JamisHoo/Cache-CPU/slides/decaf.pdf

# 编译原理扩展实验

胡津铭 李天润 孙皓
2015.1.24

# 实验⺫⽬目标

- 改造Decaf/Mind编译器，使⽣生成代码能运⾏行在
- 基于MIPS32指令⼦子集的多周期处理器
- μcore OS

# 实现⽅方法

- 指令集
- add, sub, neg
- mul
- div, rem

# 实现⽅方法

- 库函数
- PrintString
- PrintInt
- PrintBool
- ReadLine
- ReadInteger
- Halt
- Allocate
- Div
- Mod

# 实现⽅方法

- 函数调⽤用
- μcore采⽤用o32 ABI
- Decaf全部在栈上传递
- 添加中间层函数

# 实现⽅方法

- 程序退出
- μcore OS要求程序返回0
- Decaf返回类型为void
- main函数返回前加⼊入move $v0, $zero

# 实现⽅方法

- string类型
- Decaf没有垃圾回收机制
- μcore⽤用户态申请堆空间功能不完善
- 使⽤用静态存储区模拟动态分配

# 实验结果

- 含有乘法、除法运算的math
- 递归函数调⽤用的fibonacci
- 标准输⼊入输出、模运算的blackjack

# Thanks！
