JamisHoo/Cache-CPU/product_requirement_document/sections/section1_introduction.tex

\section{引言}
    \subsection{编写目的}
        计算机组成原理32位MIPS实验是在计原16位实验的基础上的扩展。%
        在实验原理方面与多门课程相结合，%
        涉及到操作系统、软件工程、编译原理等等多个方面，%
        实验初期学习曲线较陡，在原理方面比较难以掌控。%
        在编程实现方面涉及到大规模VHDL代码的书写，%
        需要对数字逻辑设计有比较清晰的思路，工作量非常大。

        因此，为控制整个开发过程，明确项目需求与目标，编写此需求文档。 

        文档预期读者为任务提出者：刘卫东老师、李山山老师、白晓颖老师。
    \subsection{背景}
        系统名称：32位MIPS处理器

        任务提出者：
        \begin{minipage}[t]{0.8\linewidth}
        计算机组成原理课程：刘卫东老师、李山山老师

        软件工程课程：白晓颖老师
        \end{minipage}

        开发者：
        \begin{minipage}[t]{0.8\linewidth}
        计23 李天润

        计23 胡津铭

        计23 孙皓
        \end{minipage}

    \subsection{定义}
        以下是此次32位MIPS实验中需要用到的专业名词定义

        \begin{table}[!hbp]
        \centering
        \caption{定义列表}
        \begin{tabular}{|c|c|}
        \hline
        名词 & 描述 \\
        \hline
        MIPS & 无内部互锁流水级的微处理器 \\
        \hline
        CPU &  中央处理器\\
        \hline
        CP0 & 协处理器0 \\
        \hline
        MMU & 内存管理单元 \\
        \hline
        TLB & 翻译后备缓冲 \\
        \hline
        ALU & 算术逻辑单元 \\
        \hline
        RAM & 存储程序的硬件，断电不保存信息 \\
        \hline
        ROM & 存储程序的硬件，断电可保存信息 \\
        \hline
        Flash & 存储程序的硬件，断电可保存信息，实验中用作硬盘 \\
        \hline
        BIOS & 主板上的启动程序，负责初始化硬件引导操作系统 \\
        \hline
        BootLoader & 一段特殊程序，将操作系统从Flash中加载到内存中，并且开始执行 \\
        \hline
        \end{tabular}
        \end{table}

    \subsection{参考资料}
        实验指导文档

        OsLab实验参考文档

        计算机组成原理综合实验报告 贾开

        《计算机组成和设计 硬件/软件接口》

        《See MIPS Run》
