JamisHoo/Cache-CPU/technical_documentation/sections/section6_dirtree.tex

\section{文件结构}
    \dirtree{%
        .1 /.
            .2 bin\DTcomment{二进制文件}.
                .3 cacpu.bit\DTcomment{CPU，烧入FPGA}.
                .3 cpld.jed\DTcomment{烧入CPLD}.
                .3 kernel\DTcomment{操作系统内核}.
                .3 sfs.img\DTcomment{文件系统}.
                .3 cadb.bit\DTcomment{带有Cache Debugger调试工具的CPU}.
            .2 design\DTcomment{设计资料}.
                .3 datapath.xls\DTcomment{数据通路指令信号说明}.
            .2 product\_requirement\_document\DTcomment{需求文档}.
            .2 src\DTcomment{源代码}.
                .3 cacpu\DTcomment{Cache CPU}.
                    .4 cacpu.xise\DTcomment{工程文件}.
                    .4 CP0.vhd\DTcomment{CP0模块}.
                    .4 Exception.vhd\DTcomment{异常处理模块}.
                    .4 IDecode.vhd\DTcomment{指令解析模块}.
                    .4 IDecode\_const.vhd\DTcomment{指令解析常量}.
                    .4 IFetch.vhd\DTcomment{取指令模块}.
                    .4 WB.vhd\DTcomment{写回模块}.
                    .4 alu.vhd\DTcomment{ALU模块}.
                    .4 async.v\DTcomment{开源串口异步收发模块}.
                    .4 cacpu.ucf\DTcomment{管脚绑定}.
                    .4 cacpu.vhd\DTcomment{顶层控制模块}.
                    .4 common.vhd\DTcomment{通用常量}.
                    .4 flash.vhd\DTcomment{Flash操作模块}.
                    .4 general\_register.vhd\DTcomment{通用寄存器模块}.
                    .4 mem.vhd\DTcomment{访存模块}.
                    .4 mmu\_module.vhd\DTcomment{MMU模块}.
                    .4 phy\_mem.vhd\DTcomment{物理访存模块}.
                    .4 ram.vhd\DTcomment{RAM读写模块}.
                    .4 rom.vhd\DTcomment{ROM读写模块}.
                .3 cpld\DTcomment{CPLD}.
                    .4 cpld.ucf\DTcomment{管脚绑定}.
                    .4 cpld.vhd\DTcomment{转发程序}.
                    .4 cpld.xise\DTcomment{工程文件}.
                .3 cadb\DTcomment{Cache Debugger}.
                    .4 com\_debug.vhd\DTcomment{调试命令收发解析}.
                    .4 bp\_debug.vhd\DTcomment{调试控制模块}.
                    .4 testcpu.vhd\DTcomment{顶层模块}.
                    .4 testcpu.ucf\DTcomment{管脚绑定}.
            .2 technical\_documentation\DTcomment{技术文档}.
            .2 ucore\_modified\DTcomment{修改后的ucore}.
                .3 lab8\DTcomment{lab8源代码}.
            .2 utils\DTcomment{调试工具}.
                .3 cadb\DTcomment{GDB调试工具}.
                .3 com2flash\DTcomment{flash与ram的读写工具}.
                .3 rom\DTcomment{rom生成工具}.
                .3 terminal\DTcomment{电脑接收端}.
    }
