JamisHoo/Cache-CPU/utils/cadb/manual/sections/section_overview.tex

\section{概述}
    \subsection{用途}
        Cache Debugger是一个基于串口的VHDL通用调试工具。%
        使用本工具可以在PC端发送指令到硬件系统，%
        具有启动、断点、继续运行、单步调试、查看信号等多种功能。%

    \subsection{系统配置}
        带有串口的目标设备
        
        支持VHDL语言和该目标设备的集成软件开发环境

        Unix或类Unix操作系统，安装有串口设备驱动，支持C++11的编译器
