JamisHoo/Cache-CPU/documentation/cadb_technical_document.pdf

# Cache Debugger技术文档

### Cache小组

2015年1月11日

目录

1 引言 | 2
2 设计原理 | 2
3 硬件部分 | 2
4 软件部分 | 5
5 高级应用 | 7

1

1 引言

### 1.1 开发信息

系统名称：硬件调试工具Cache Debugger
开发者： 计23 李天润
计23 胡津铭
计23 孙皓

### 1.2 内容简介

本文档介绍了硬件调试工具的功能设计以及软硬件部分实现细节，方便读者 更深入了解本工具的运行方式，以及根据自己的需要对工具进行修改、二次开 发。
本文档假设读者已经阅读过调试工具的使用手册，并且了解硬件描述语言的 基本应用以及元件例化的方法。

## 2 设计原理

硬件逻辑分时序逻辑与组合逻辑，其中组合逻辑仅与输入有关，时序逻辑受 时钟控制。
在系内课程与FPGA有关的实验中，并没有涉及与延时相关的逻辑，比如振 荡电路，因此FPGA芯片内部的硬件延时在设计硬件逻辑时一般不会被考虑，仅 影响时钟频率的提高。基于以上考虑，可以认为大多数实验中，硬件逻辑的执 行是由时钟驱动的，因此控制了时钟也就控制了逻辑的执行。而且，由于设计 逻辑时不会将延时作为正面的逻辑功能的一部分，时钟沿无论延迟多久到达都 不会产生负面作用，因此暂停时钟相当于将电路暂停，之后再次给入时钟信号 即可无损地继续执行程序。
本工具正是基于以上结论，结合调试的断点信息，产生被调试模块的时钟信 号，使得被调试模块既可正常运行，又可以在给定的状态下暂停，查看调试信 息。
通过逻辑操作，本工具可以为被调试模块提供与调试工具的输入时钟信号相 同频率的时钟信号，使得被调试模块在调试环境下有着与实际单独运行时几乎 相同的表现。

## 3 硬件部分

### 3.1 整体设计

硬件部分，需要在软件客户端的控制下，产生适当的时钟信号，控制程序运 行指定的时钟数或者运行到指定的断点状态。
运行结束之后，应当将硬件上的信号值发送到客户端，以供调试人员查看信 号值，分析芯片运行状况。
调试工具的硬件部分工作流程如图1。

2

图 1: 硬件部分工作流程示意图

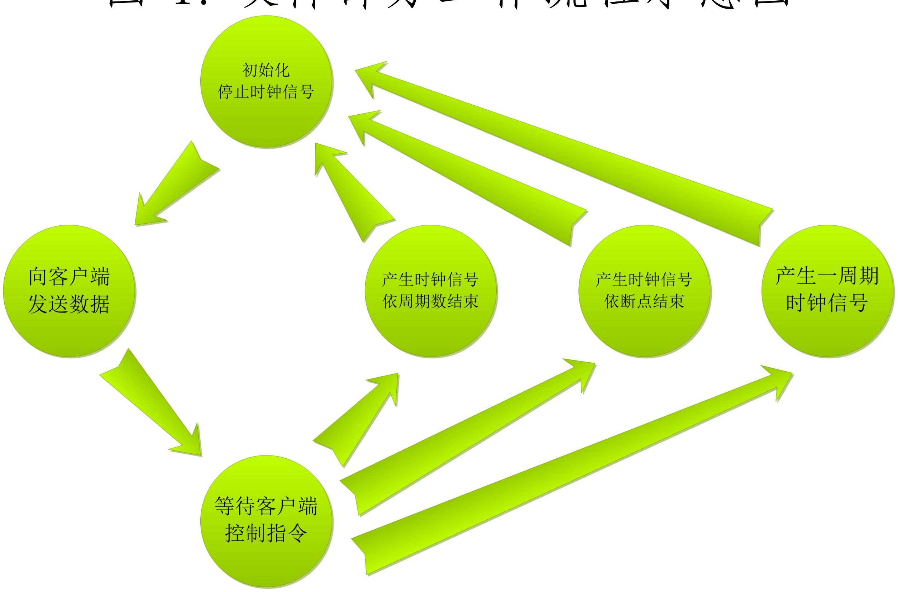
[picture p15: figure]

上述功能由两个模块实现，一个模块用于与客户端进行通信，另一个模块用 于控制被调试模块的时钟信号以及调试工具的状态跳转。

### 3.2 模块设计

3.2.1 控制模块

此模块位于bp_debug.vhd

3.2.1.1 端口说明

端口名 | 端口方向 端口类型
端口描述
clk | in | std_logic
| 时钟输入。
clk_o | out | std_logic
由此模块产生的时钟信号，可直接作为被测试模块的时
| 钟。
e | in | std_logic
| 使能信号。
datas | in | std_logic_vector ( 4095 downto 0 )
从被测试模块发来的信号值数据。
monitor | in | std_logic_vector ( 63 downto 0 )
从被测试模块发来的监控信号数据，用于断点的监控。
serialport_txd | out | std_logic
串口写端口。
serialport_rxd in | std_logic
| | 3

串口读端口。

3.2.1.2 内部实现
控制模块的状态机大致与调试工具硬件部分的工作流程相对应。 需要查看的信号值部分，从被调试模块获取信号值（默认长度为4096bit）， 使用组合逻辑的方法根据通信模块给出的字节编号选取对应的字节提供给通信 模块。
调试部分，目前仅支持在上升沿之前断点，实现方式为输出时钟由两个中 间值取异或得到。一个中间值的改变由输入时钟下降沿触发，在输出时钟为高 电平时对其取反。令一个中间值的改变由输入时钟上升沿触发，在程序运行阶 段，且仍需继续运行时，如果输出时钟为低电平，则将其取反。 被调试模块是否应当继续运行，根据指令的不同而有不同的判断方式。 对于断点调试而言，当检测信号与段电信号值相同时应当进行停止运行，否 则应当继续运行。
对于继续调试而言，应当无条件给出一个周期的时钟信号，然后按照断点调 试判断。
对于单步调试而言，设置一个倒计时计数器，每次时钟上升沿减一且被调试 模块运行，减到0时被调试模块停止运行。

3.2.2 通信模块

此模块位于com_debug.vhd

3.2.2.1 端口说明

端口名 | 端口方向 端口类型
端口描述
clk | in | std_logic
串口发送部分开始信号。
slc | out | std_logic_vector(15 downto 0)
串口发送的字节编号，用于从上层模块获取对应字节。
data | in | std_logic_vector ( 7 downto 0 )
串口发送的字节值，使用编号slc从上层模块获取。
serialport_txd | out | std_logic
串口写端口。
serialport_rxd in | std_logic
串口读端口。
data_coming | out | std_logic

4

标志位，表示客户端指令到来。
coming_data | out | std_logic_vector ( 135 downto 0 )
来自客户端的指令信息。 高64位为客户端第二个参数； 中 64位为客户端第一个参数； 低8位表示指令类型。
data_read | in | std_logic
标志位，表示这一指令已经被读取，可以消除指令到来信
号。

3.2.2.2 内部实现
通信模块包括接受与发送两部分，分别工作，相互不影响，通过软件端、控 制模块保证发送与接受的顺序。
发送部分用于运行结束时，向客户端发送需要的内部信号值。收到控制端的 发送开始信号后，从0号字节开始循环发送。这一部分使用slc端口给出字节编 号，然后由data读入字节信息，通过串口发送。
接收部分从软件端接受指令，收到17个字节后，通过标志位通知控制模块 数据到来，同时提供数据。收到控制模块读走数据的信号后，接收部分将数据 到来标志位清零，同时继续等待新数据到来。
此部分工作频率默认在50MHz，频率不符会导致此部分不能正常工作。修 改频率请在async.v中做修改。

## 4 软件部分

### 4.1 设计原理

软件端设计与硬件端匹配，与硬件端约定接收、发送规则，接收、发送消息 的格式，同时为了解决数据传输过程中可能出现的错误，还需要处理系统缓冲 区、检测丢包现象，从而保证调试工具正常运行。

### 4.2 整体设计

软件端开始运行后读取配置文件，尝试连接串口，以上操作均成功后，进入 用户操作界面。

4.2.1 通信命令编码

对于每个用户输入的命令，软件端将命令编码后发送给硬件端，根据命令类 型决定是否阻塞并等待硬件端数据。
通信编码共17字节，命令编码规则如下表所示。图中编码低序字节最先发 送，高序字节最后发送。
命令 | 通信编码 | 说明

5

run | 0x<128位全0>01 | 运行此命令后软件端阻塞，等 待硬件端数据。
break | 0x<64位掩码><64位数据>02 64位数据为断点条件，掩码为
| | 1表示数据有效，掩码为0表示 数据通配，数据和掩码均采用 小端法。
continue | 0x<128位全0>03 | 运行此命令后软件端阻塞，等 待硬件端数据。
step | 0x<64位全0><64位数据>04 | 64位数据为前进时钟数，运行 此命令后软件端阻塞，等待硬 件端数据。
print | | 此命令无需与硬件端通信。
display | | 此命令无需与硬件端通信。
undisplay | | 此命令无需与硬件端通信。
help | | 此命令无需与硬件端通信。
quit | | 此命令无需与硬件端通信。

4.2.2 通信数据编码

软件运行后会自动读取当前目录下cadb.cfg文件。配置文件需要用户自行编 写，共三列，第一列是软件端查看变量值时的标签，接受不包含空白字符的字 符串。 第二列是VHDL源代码中实际被查看信号名称，接收不包含空白字符的 字符串，在被调试模块中应有同名信号，且该信号不能为输出端口。 第三列是 被查看信号的范围。对于std_logic_vector应标明范围，对于std_logic第三列置 空。
生成VHDL代码时，程序会根据信号长度在通信数据格式中从低到高分配， 对于长度不是8的整数倍的信号，会填充0以实现8对齐。每次收到硬件端发送 的数据后，软件端会根据该格式解析出对应的信号值。因此每次修改配置文件 后都应该重新生成VHDL代码并应用到硬件中。数据在传输和保存过程中采用 小端法，因此在打印变量时从高序字节开始打印。
若要修改通信数据总长度，应在软件端源代码中修改类Parser的静态成员常 量MSG_LENGTH的值，同时在硬件端做相应修改。注意该值在软件端以字节为 单位，在硬件端以位为单位。

4.2.3 系统缓冲区管理

Unix操作系统中为串口设置有缓冲区，缓冲区大小因操作系统不同而有所 差异。
为了避免软件运行过程中受缓冲区原有数据影响而造成通信不同步，软件 启动时和run命令发送之前应清空系统缓冲区。清空方法为：不断尝试读取串 口，直到连续10ms读取不到数据为止。

6

4.2.4 丢包检测

在软硬件两端通信协议设置正确且硬件运行过程中能够到达断点条件的前提 下，软件端一直阻塞，则说明发生了串口传输丢包现象。此时应重启软件端。 本工具自开发使用以来从未发现丢包现象。

4.2.5 串口通信参数

软件端串口通信管理在源代码类Communicator中，如果需要修改波特率等 串口通信参数，请在硬件端和软件端同时修改。

## 5 高级应用

此部分涉及较多细节，请在理解本文档前述部分之后再进行阅读。

### 5.1 断点调试

本调试工具的断点调试可以按照64位均匹配的方式执行，也可以根据需要 进行一定的通配匹配。
对于包含通配符的断点信息，来自客户端的指令的第二个参数不再是 0xFFFFFFFF，而在需要通配的位上为0。断点的匹配是将断点值与监控值作 异或，如果结果为0x00000000，则表示到达断点。考虑通配符后，异或的结 果会再与通配值进行与操作，将被设为通配的位置0，从而使其不再参与断点 匹配。

### 5.2 观察信号变长

默认文件中，观察信号长度为4096bit，使用中可以将CPU顶层模块的所有 信号以及通用寄存器、CP0寄存器的所有信号发到客户端， 而且发送这一长度 的观察信号消耗的时间在通过终端查看的情况下可以忽略。 使用中，考虑到不同的使用者可能有不同的需要，比如自动调试中希望每次 发送更少的信号值或者需要发送更多的信号，在此给出改变观察信号长度的方 法。
改变观察信号长度，需要将被调试模块中的输出数据长度改变，调试模块的 输入数据长度改变。
接下来，需要将数据发送部分的字节编号范围改为需要的数值，此处需修改 com_debug.vhd中的常量slc_max。
最后，需要在软件端进行相应修改，使其一次性接受的信号数量匹配。

7
