JamisHoo/Cache-CPU/design/datapath.xls

Sheet: ALU控制
ALUOP |  |  | ALUOp改为5位
00000 | +
00001 | - | SrcA - SrcB
00010 | 是否相等
00011 | &
00100
00101 | ^
00110 | ~
00111 | << | SrcB << SrcA
01000 | >>（arith） | SrcB >> SrcA
01001 | >>（logic） | SrcB >> SrcA
01010 | 有符号小于比较 | 1<2?小于结果输出1，否则结果输出0
01011 | 无符号小于比较（一个需要元件例化） | 1<2?小于结果输出1，否则结果输出0
10000 | 乘法 | srcA*srcB
10001 | read_lo
10010 | read_hi
10011 | write_lo
10100 | write_hi
ALU输出
ans | 计算结果

Sheet: 多周期
指令 | 指令31-26 | 指令5-0
ADDIU | 001001 | XXXXXX | 执行 | ALUSrcA | ALUSrcB | ALUOp | Immediate |  | 写回 | RegDst | RegValue | PcSource
 |  |  |  | 00 | 01 | 0000 | 00 |  |  | 00 | 000 | 00
ADDU | 000000 | 100001 | 执行 | ALUSrcA | ALUSrcB | ALUOp |  |  | 写回 | RegDst | RegValue | PcSource
 |  |  |  | 00 | 00 | 0000 |  |  |  | 01 | 000 | 00
SLT | 000000 | 101010 | 执行 | AlUSrcA | ALUSrcB | ALUOp |  |  | 写回 | RegDst | RegValue | PcSource
 |  |  |  | 00 | 00 | 1010 |  |  |  | 01 | 000 | 00
SLTI | 001010 | XXXXXX | 执行 | ALUSrcA | ALUSrcB | ALUOp | Immediate |  | 写回 | RegDst | RegValue | PcSource
 |  |  |  | 00 | 01 | 1010 | 00 |  |  | 00 | 000 | 00
SLTIU | 001011 | XXXXXX | 执行 | ALUSrcA | ALUSrcB | ALUOp | Immediate |  | 写回 | RegDst | RegValue | PcSource
 |  |  |  | 00 | 01 | 1011 | 01 |  |  | 00 | 000 | 00
SLTU | 000000 | 101011 | 执行 | ALUSrcA | ALUSrcB | ALUOp |  |  | 写回 | RegDst | RegValue | PcSource
 |  |  |  | 00 | 00 | 1011 |  |  |  | 01 | 000 | 00
SUBU | 000000 | 100011 | 执行 | ALUSrcA | ALUSrcB | ALUOp |  |  | 写回 | RegDst | RegValue | PcSource
 |  |  |  | 00 | 00 | 0001 |  |  |  | 01 | 000 | 00
MULT | 000000 | 011000 | 执行 | ALUSrcA | ALUSrcB | ALUOp |  |  | 写回 | RegWrite |  | PcSource
 |  |  |  | 00 | 00 | 10000 |  |  |  | 0 |  | 00
MFLO | 000000 | 010010 | 执行 | ALUSrcA | ALUSrcB | ALUOp |  |  | 写回 | RegDst | RegValue | PcSource
 |  |  |  | 00 | 00 | 10001 |  |  |  | 01 | 000 | 00
MFHI | 000000 | 010000 | 执行 | ALUSrcA | ALUSrcB | ALUOp |  |  | 写回 | RegDst | RegValue | PcSource
 |  |  |  | 00 | 00 | 10010 |  |  |  | 01 | 000 | 00
MTLO | 000000 | 010011 | 执行 | ALUSrcA | ALUSrcB | ALUOp |  |  | 写回 | RegWrite |  | PcSource
 |  |  |  | 00 | 00 | 10011 |  |  |  | 0 |  | 00
MTHI | 000000 | 010001 | 执行 | ALUSrcA | ALUSrcB | ALUOp |  |  | 写回 | RegWrite |  | PcSource
 |  |  |  | 00 | 00 | 10100 |  |  |  | 0 |  | 00
BEQ | 000100 | XXXXXX | 执行 | Immediate | AluSrcA | AluSrcB | ALUOp |  | 写回 | PcSource | RegWrite
 |  |  |  | 00 | 00 | 00 | 0010 |  |  | 01 | 0
BGEZ | 000001 | XXXXXX |  | Immdiate | AluSrcA | AluSrcB | ALUOp |  | 写回 | PcSource | RegWrite
 |  |  |  | 00 | 00 | 10 | 0001 |  |  | 01 | 0
BGTZ | 000111 | XXXXXX |  | Immdiate | AluSrcA | AluSrcB | ALUOp |  | 写回 | PcSource | RegWrite
 |  |  |  | 00 | 00 | 10 | 0001 |  |  | 01 | 0
BLEZ | 000110 | XXXXXX |  | Immdiate | AluSrcA | AluSrcB | ALUOp |  | 写回 | PcSource | RegWrite
 |  |  |  | 00 | 00 | 10 | 0001 |  |  | 01 | 0
BLTZ | 000001 | XXXXXX |  | Immdiate | AluSrcA | AluSrcB | ALUOp |  | 写回 | PcSource | RegWrite
 |  |  |  | 00 | 00 | 10 | 0001 |  |  | 01 | 0
BNE | 000101 | XXXXXX |  | Immediate | AluSrcA | AluSrcB | ALUOp |  | 写回 | PcSource | RegWrite
 |  |  |  | 00 | 00 | 00 | 0010 |  |  | 01 | 0
J | 000010 | XXXXXX | 写回 | PcSource | Immediate | RegWrite
 |  |  |  | 010 | 11 | 0
JAL | 000011 | XXXXXX | 写回 | PcSource | RegDst | RegValue | Immediate
 |  |  |  | 010 | 10 | 010 | 11
JALR | 000000 | 001001 | 执行 | AluSrcA | ALUSrcB | ALUOp |  |  | 写回 | PcSource | RegDst | RegValue
 |  |  |  | 00 | 10 | 0000 |  |  |  | 11 | 10 | 010
JR | 000000 | 001000 | 执行 | AluSrcA | ALUSrcB | ALUOp |  |  | 写回 | PcSource | RegWrite
 |  |  |  | 00 | 10 | 0000 |  |  |  | 11 | 0
LW | 100011 | XXXXXX | 执行 | Immediate | AluSrcA | AluSrcB | ALUOp |  | 访存 | MemRead |  |  | 写回 | RegDst | RegValue
 |  |  |  | 00 | 00 | 01 | 0000 |  |  | 1 |  |  |  | 00 | 001
SW | 101011 | XXXXXX | 执行 | Immediate | AluSrcA | AluSrcB | ALUOp |  | 访存 | MemWrite | MemValue |  | 写回 | RegWrite | PcSource
 |  |  |  | 00 | 00 | 01 | 0000 |  |  | 1 | 0 |  |  | 0 | 00
LB | 100000 | XXXXXX | 执行 | Immediate | AluSrcA | AluSrcB | ALUOp |  | 访存 | MemRead |  |  | 写回 | RegDst | RegValue | ChooseByte
 |  |  |  | 00 | 00 | 01 | 0000 |  |  | 1 |  |  |  | 00 | 100
LBU | 100100 | XXXXXX | 执行 | Immediate | AluSrcA | AluSrcB | ALUOp |  | 访存 | MemRead |  |  | 写回 | RegDst | RegValue | chooseByte
 |  |  |  | 00 | 00 | 01 | 0000 |  |  | 1 |  |  |  | 00 | 011
SB | 101000 | XXXXXX | 执行 | Immediate | AluSrcA | AluSrcB | ALUOp |  | 访存 | MemRead |  |  | 访存2 | MemWrite | MemValue |  | 写回 | RegWrite | RegValue
 |  |  |  | 00 | 00 | 01 | 0000 |  |  | 1 |  |  |  | 1 | 1 |  |  | 0 | 100
AND | 000000 | 100100 | 执行 | AluSrcA | AluSrcB | ALUOp |  |  | 写回 | RegDst | RegValue
 |  |  |  | 00 | 00 | 0011 |  |  |  | 01 | 000
ANDI | 001100 | XXXXXX | 执行 | AluSrcA | AluSrcB | ALUOp | Immediate |  | 写回 | RegDst | RegValue
 |  |  |  | 00 | 01 | 0011 | 01 |  |  | 00 | 000
LUI | 001111 | XXXXXX | 执行 | AluSrcA | AluSrcB | ALUOp |  |  | 写回 | RegDst | RegValue
 |  |  |  | 11 | 00 | 0111 |  |  |  | 00 | 000
NOR | 000000 | 100111 | 执行 | AluSrcA | AluSrcB | ALUOp |  |  | 写回 | RegDst | RegValue
 |  |  |  | 00 | 00 | 0110 |  |  |  | 01 | 000
OR | 000000 | 100101 | 执行 | AluSrcA | AluSrcB | ALUOp |  |  | 写回 | RegDst | RegValue
 |  |  |  | 00 | 00 | 0100 |  |  |  | 01 | 000
ORI | 001101 | XXXXXX | 执行 | AluSrcA | AluSrcB | ALUOp | Immediate |  | 写回 | RegDst | RegValue
 |  |  |  | 00 | 01 | 0100 | 01 |  |  | 00 | 000
XOR | 000000 | 100110 | 执行 | AluSrcA | AluSrcB | ALUOp |  |  | 写回 | RegDst | RegValue
 |  |  |  | 00 | 00 | 0101 |  |  |  | 01 | 000
XORI | 001110 | XXXXXX | 执行 | AluSrcA | AluSrcB | ALUOp | Immediate |  | 写回 | RegDst | RegValue
 |  |  |  | 00 | 01 | 0101 | 01 |  |  | 00 | 000
SLL | 000000 | 000000 | 执行 | AluSrcA | AluSrcB | ALUOp | Immediate |  | 写回 | RegDst | RegValue
 |  |  |  | 01 | 00 | 0111 | 10 |  |  | 01 | 000
SLLV | 000000 | 000100 | 执行 | AluSrcA | AluSrcB | ALUOp |  |  | 写回 | RegDst | RegValue
 |  |  |  | 00 | 00 | 0111 |  |  |  | 01 | 000
SRA | 000000 | 000011 | 执行 | AluSrcA | AluSrcB | ALUOp | Immediate |  | 写回 | RegDst | RegValue
 |  |  |  | 01 | 00 | 1000 | 10 |  |  | 01 | 000
SRAV | 000000 | 000111 | 执行 | AluSrcA | AluSrcB | ALUOp |  |  | 写回 | RegDst | RegValue
 |  |  |  | 00 | 00 | 1000 |  |  |  | 01 | 000
SRL | 000000 | 000010 | 执行 | AluSrcA | AluSrcB | ALUOp | Immediate |  | 写回 | RegDst | RegValue
 |  |  |  | 01 | 00 | 1001 | 10 |  |  | 01 | 000
SRLV | 000000 | 000110 | 执行 | AluSrcA | AluSrcB | ALUOp |  |  | 写回 | RegDst | RegValue
 |  |  |  | 00 | 00 | 1001 |  |  |  | 01 | 000
SYSCALL | 000000 | 001100 | 在解码指令阶段产生异常，直接跳转到Exc周期
CACHE | 101111 | XXXXXX | 写回 | PcSource
 |  |  |  | 00
ERET | 010000 | 011000 | (仅在异常状态下使用) |  |  | 写回 | ERET使能
 |  |  |  |  |  |  | 1
MFC0 | 010000 | 000000 | 写回 | RegDst | RegValue
 |  |  |  | 00 | 110
MTC0 | 010000 | 000000 | 写回 | CP0Write
 |  |  |  | 1
TLBWI | 010000 | 000010 | 写回 | TLBwrite
 |  |  |  | 1
LHU | 100101 | XXXXXX | 执行 | Immediate | AluSrcA | AluSrcB | ALUOp | 访存 | MemRead |  | 写回 | RegDst | RegValue
 |  |  |  | 00 | 00 | 01 | 0000 |  | 1 |  |  | 00 | 101
通用操作
取指令阶段 |  |  |  |  |  |  |  |  |  | 指令解码阶段
 | MemRead |  |  |  |  |  |  |  |  | 解码指令
 | 1 |  |  |  |  |  |  |  |  | 解码，读取寄存器（包括CP0）

Sheet: 定义
MemOp | MemRead | 是否读取内存
 |  | 0 | 可以
 |  | 1 | 不可以
 | MemWrite | 是否写内存
 |  | 0 | 可以
 |  | 1 | 不可以
 | MemValue | 写入内存的数据
 |  | 0 | 寄存器数据2
 |  | 1 | SB指令处理后的数据
PcOp | PcSource | PC寄存器的来源
 |  | 00 | PC+4的计算结果
 |  | 01 | PC计算单元的结果
 |  | 10 | Jump指令的地址
 |  | 11 | 主ALUOut的计算结果
WBOp | RegDst | 写回哪个寄存器（直接从控制单元接一个5位的信号）
 |  | 00 | 16-20位：rt
 |  | 01 | 11-15位：rd
 |  | 10 | 31号寄存器
 | RegValue | 写回寄存器来源
 |  | 000 | ALU计算结果
 |  | 001 | 内存
 |  | 010 | RPC
 |  | 011 | ZeroExt（内存Byte），需要与ChooseByte结合
 |  | 100 | SignExt（内存Byte），需要与ChooseByte结合
 |  | 101 | ZeroExt（内存16）
 |  | 110 | CP0寄存器
 | RegWrite | 在RegValue，RegDst作用时置1
 |  | 0
 |  | 1
CP0Op | EPCValue | 发生异常的时候EPC写入什么
 |  | 0 | PC
 |  | 1 | PC+4
 | CP0Write | CP0是否写
TLBWrite | 是否写TLB
 | 0 | 否
 | 1 | 是
ChooseByte | 访存地址的后两位，LB、SB指令对哪个byte进行扩展，同RegValue共同进行控制
 | 00 | 第0个
 | 01 | 第1个
 | 10 | 第2个
 | 11 | 第3个
ALUSrcA | ALU输入的第一个参数
 | 00 | 寄存器数据1
 | 01 | Immediate
 | 10 | CP0寄存器
 | 11 | 16（LUI指令）
ALUSrcB | ALU输入的第二个参数
 | 00 | 寄存器数据2
 | 01 | Immediate
 | 10 | 0
 | 11 | 暂无
Immediate | 解码产生立即数，32位送到ALUSrcA,ALUSrcB
 | 00 | 16位有符号扩展
 | 01 | 16位无符号扩展
 | 10 | 5位到32位扩展
 | 11 | Jump指令的扩展
comp_op | branch指令的比较方式
 | 000 | BEQ（R[s] = R[t]）
 | 001 | BGEZ(R[s] >= 0)
 | 010 | BGTZ(R[s] > 0)
 | 011 | BLEZ(R[s] <= 0)
 | 100 | BLTZ(R[s] < 0)
 | 101 | BNE(R[s] ！= R[t])
state_op | 后续周期变化
 | 000 | 执行 | 写回
 | 001 | 执行
 | 010 | 写回
 | 011 | 执行 | 访存1 | 写回
 | 100 | 执行 | 访存1
 | 101 | 执行 | 写回 | 访存1 | 访存2
