JamisHoo/Cache-CPU/product_requirement_document/chart/insert0.jpg

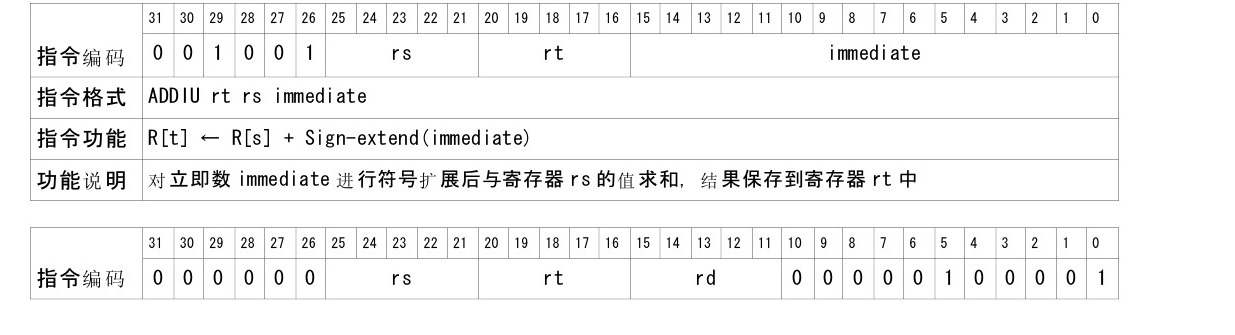
product_requirement_document/chart/insert0.jpg
