JamisHoo/Cache-CPU/product_requirement_document/chart/insert1.jpg

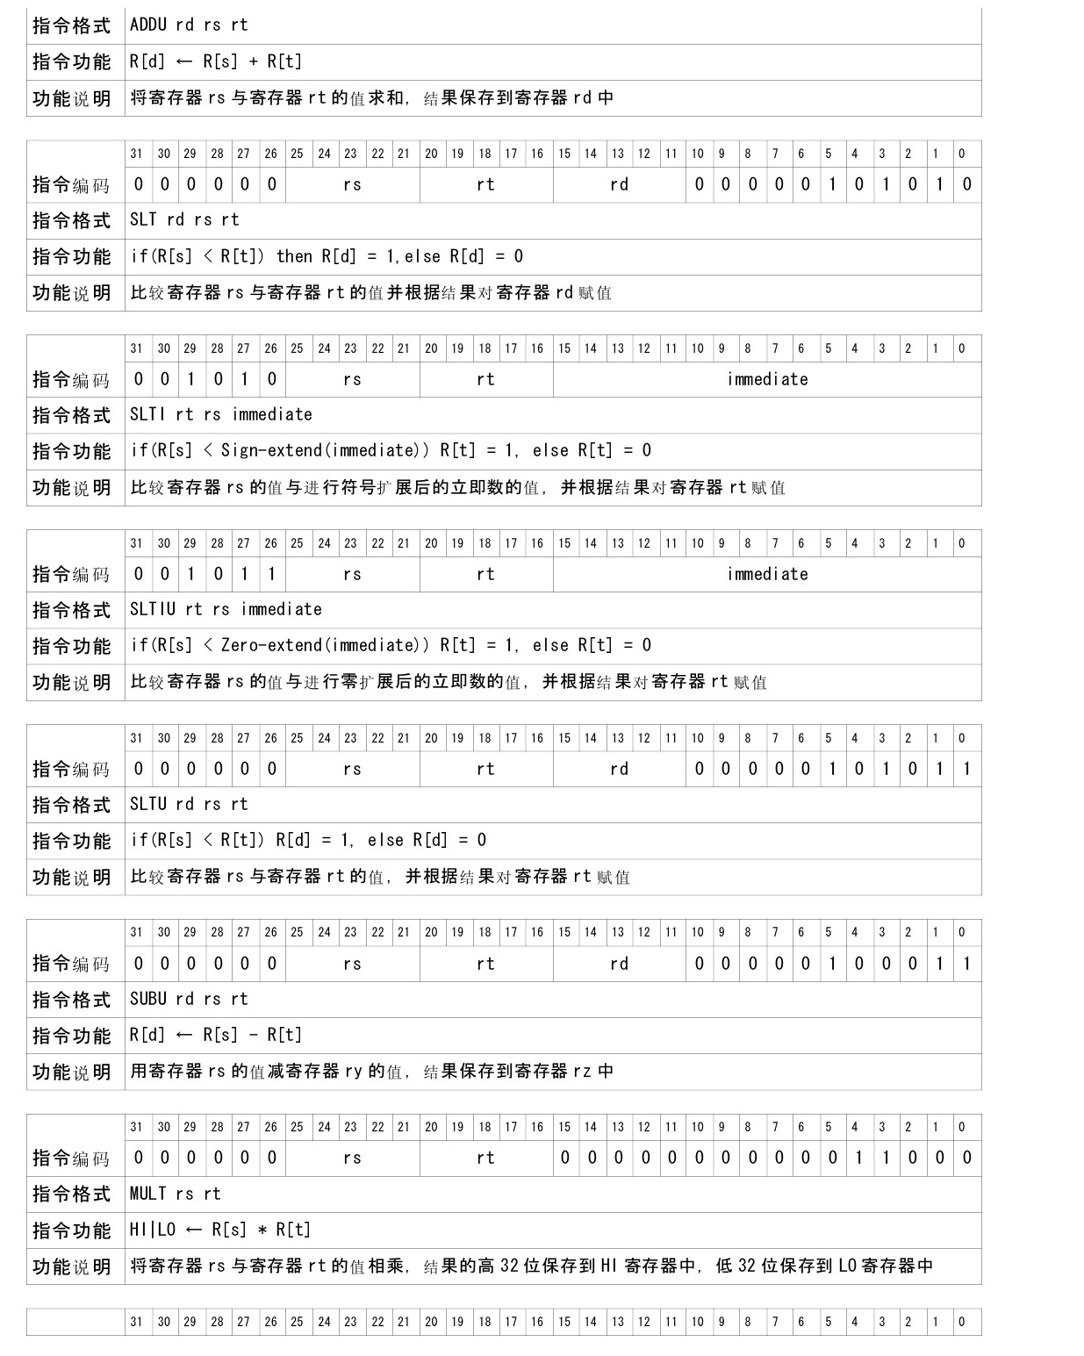
product_requirement_document/chart/insert1.jpg
