JamisHoo/Cache-CPU/product_requirement_document/chart/insert2.jpg

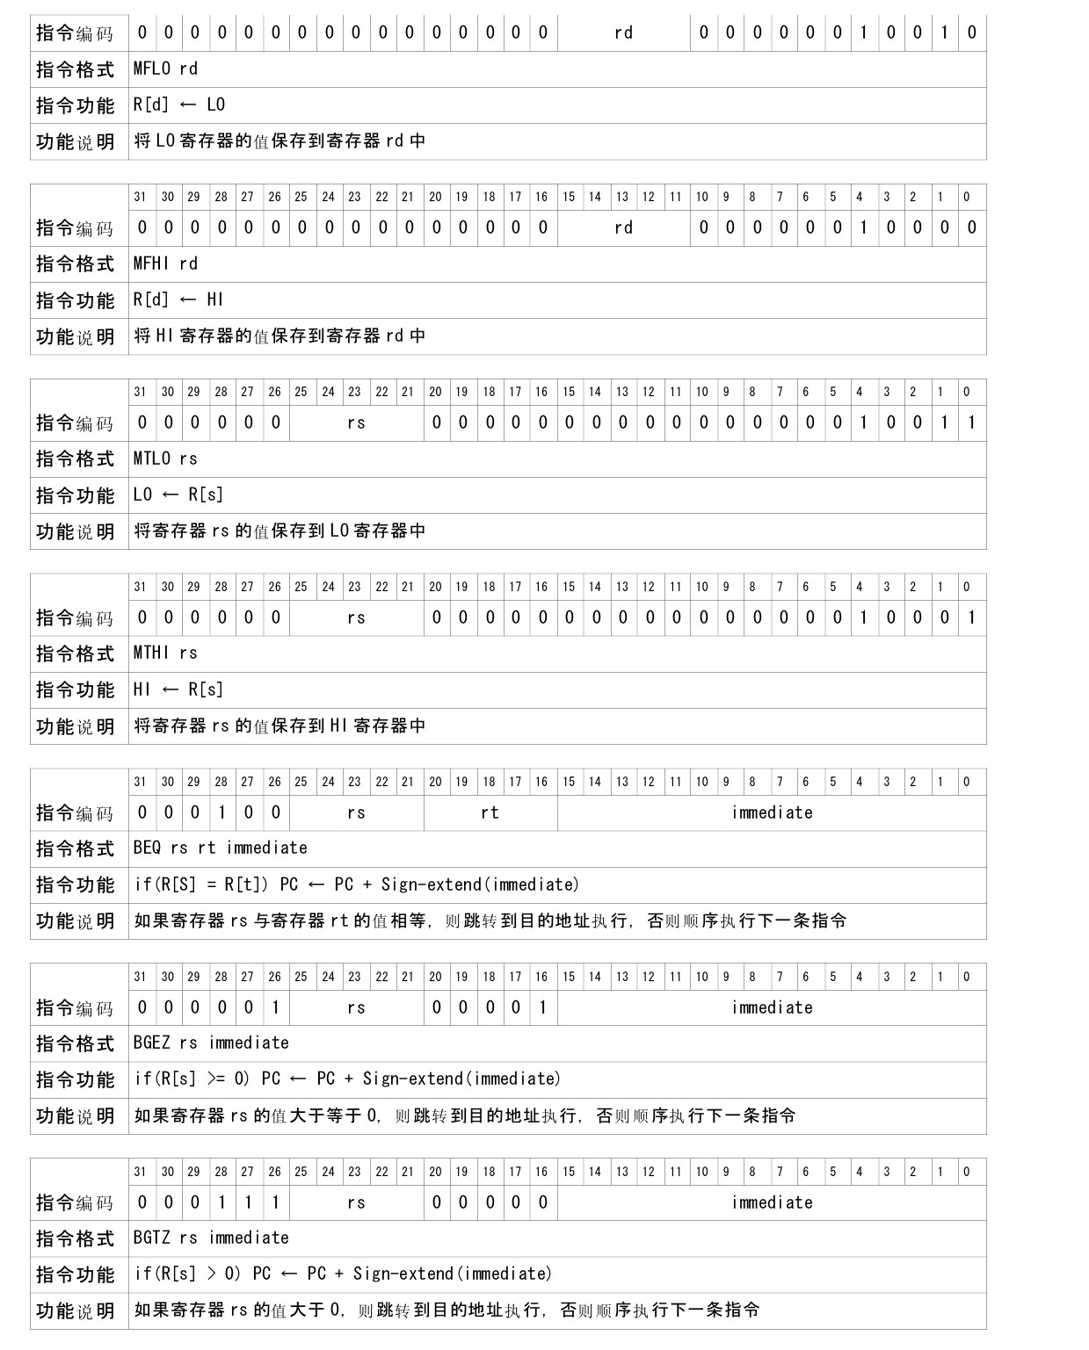
product_requirement_document/chart/insert2.jpg
