JamisHoo/Cache-CPU/product_requirement_document/chart/insert3.jpg

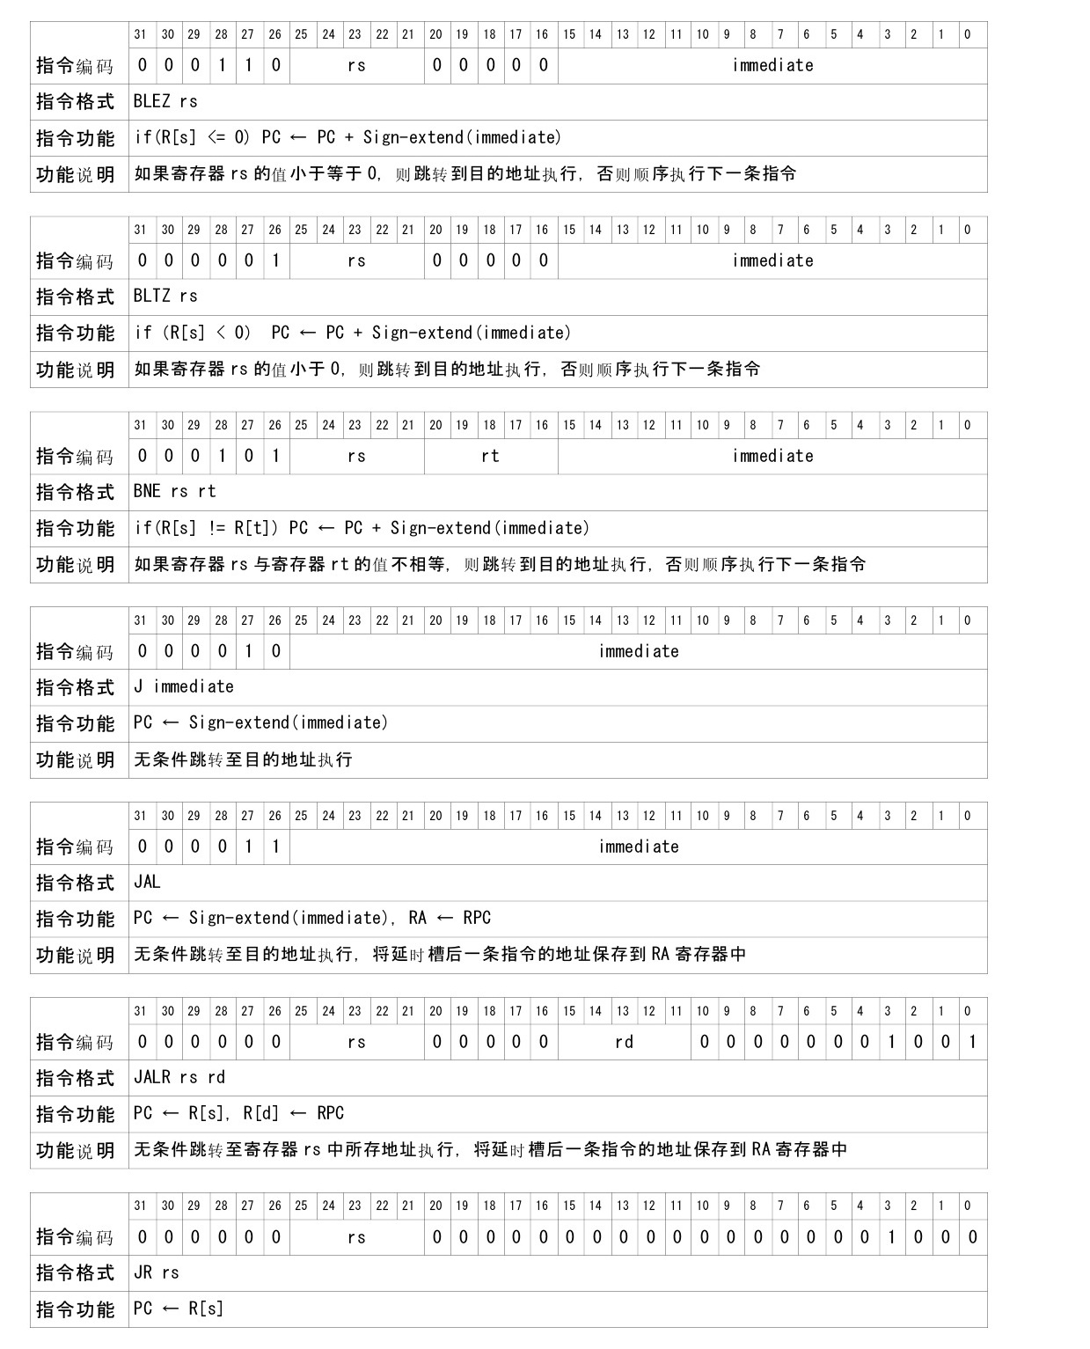
product_requirement_document/chart/insert3.jpg
