JamisHoo/Cache-CPU/product_requirement_document/chart/insert4.jpg

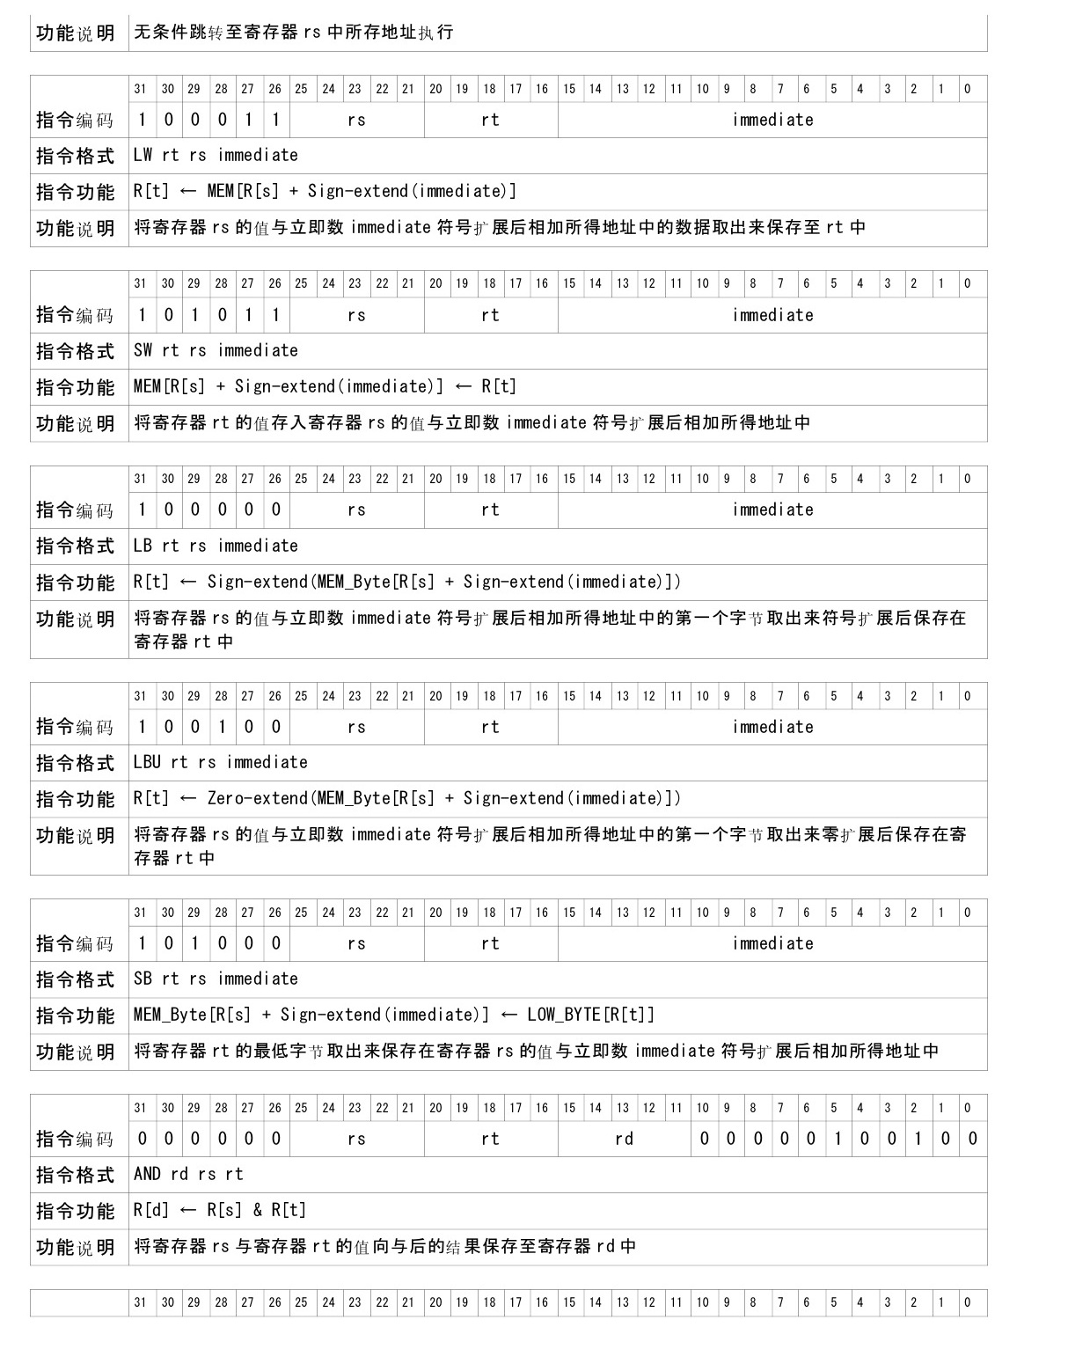
product_requirement_document/chart/insert4.jpg
