JamisHoo/Cache-CPU/product_requirement_document/chart/insert5.jpg

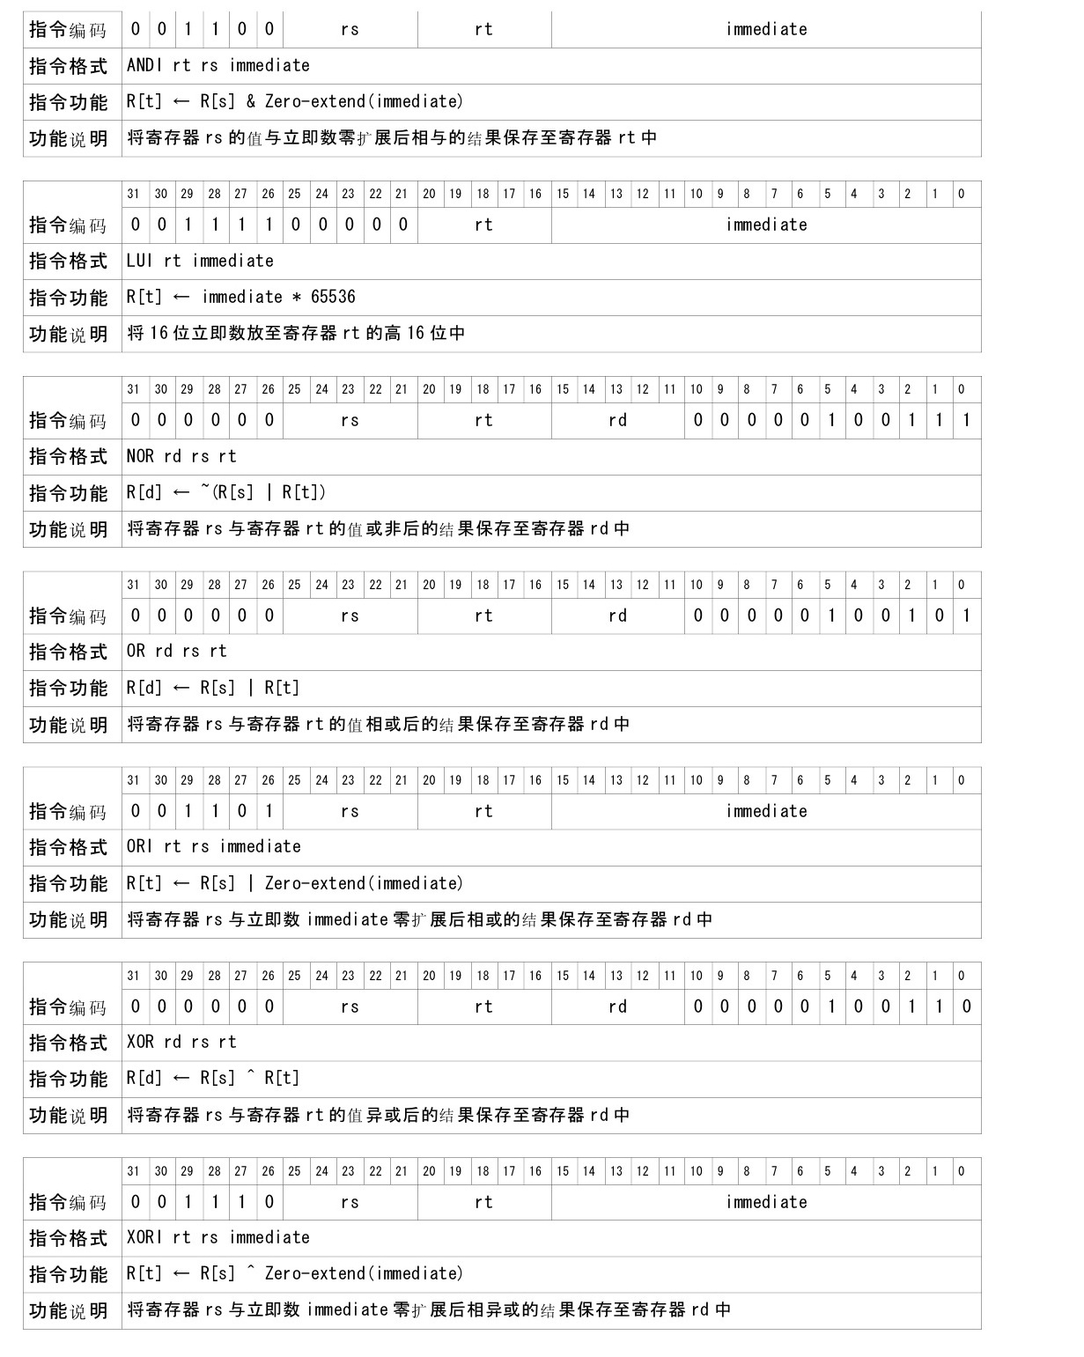
product_requirement_document/chart/insert5.jpg
