JamisHoo/Cache-CPU/product_requirement_document/chart/insert6.jpg

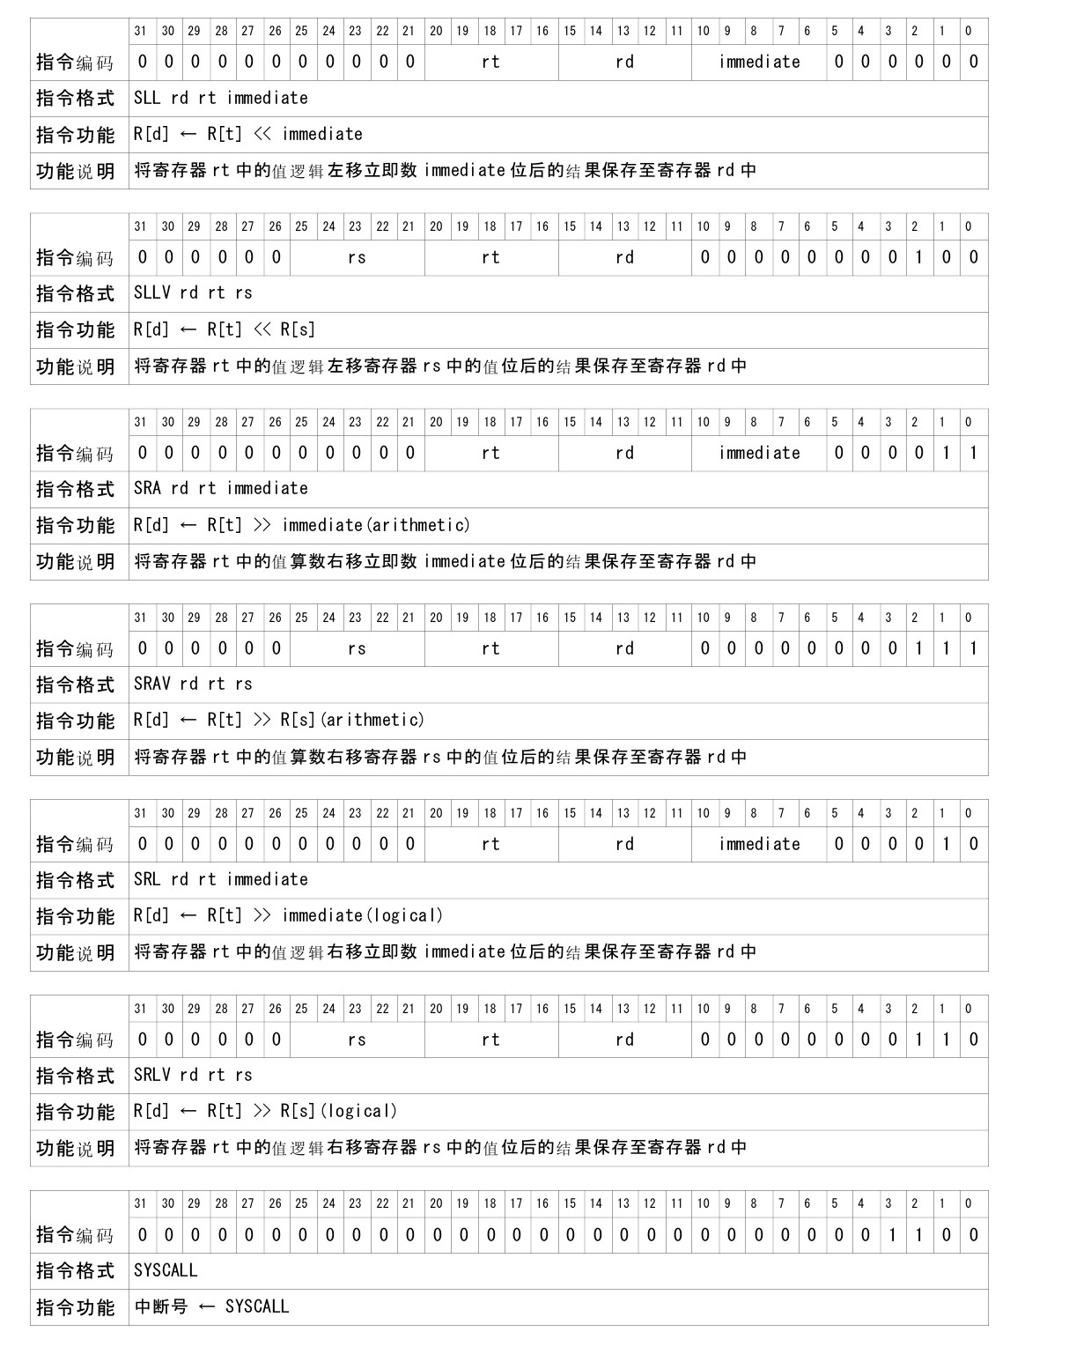
product_requirement_document/chart/insert6.jpg
