JamisHoo/Cache-CPU/product_requirement_document/chart/insert7.jpg

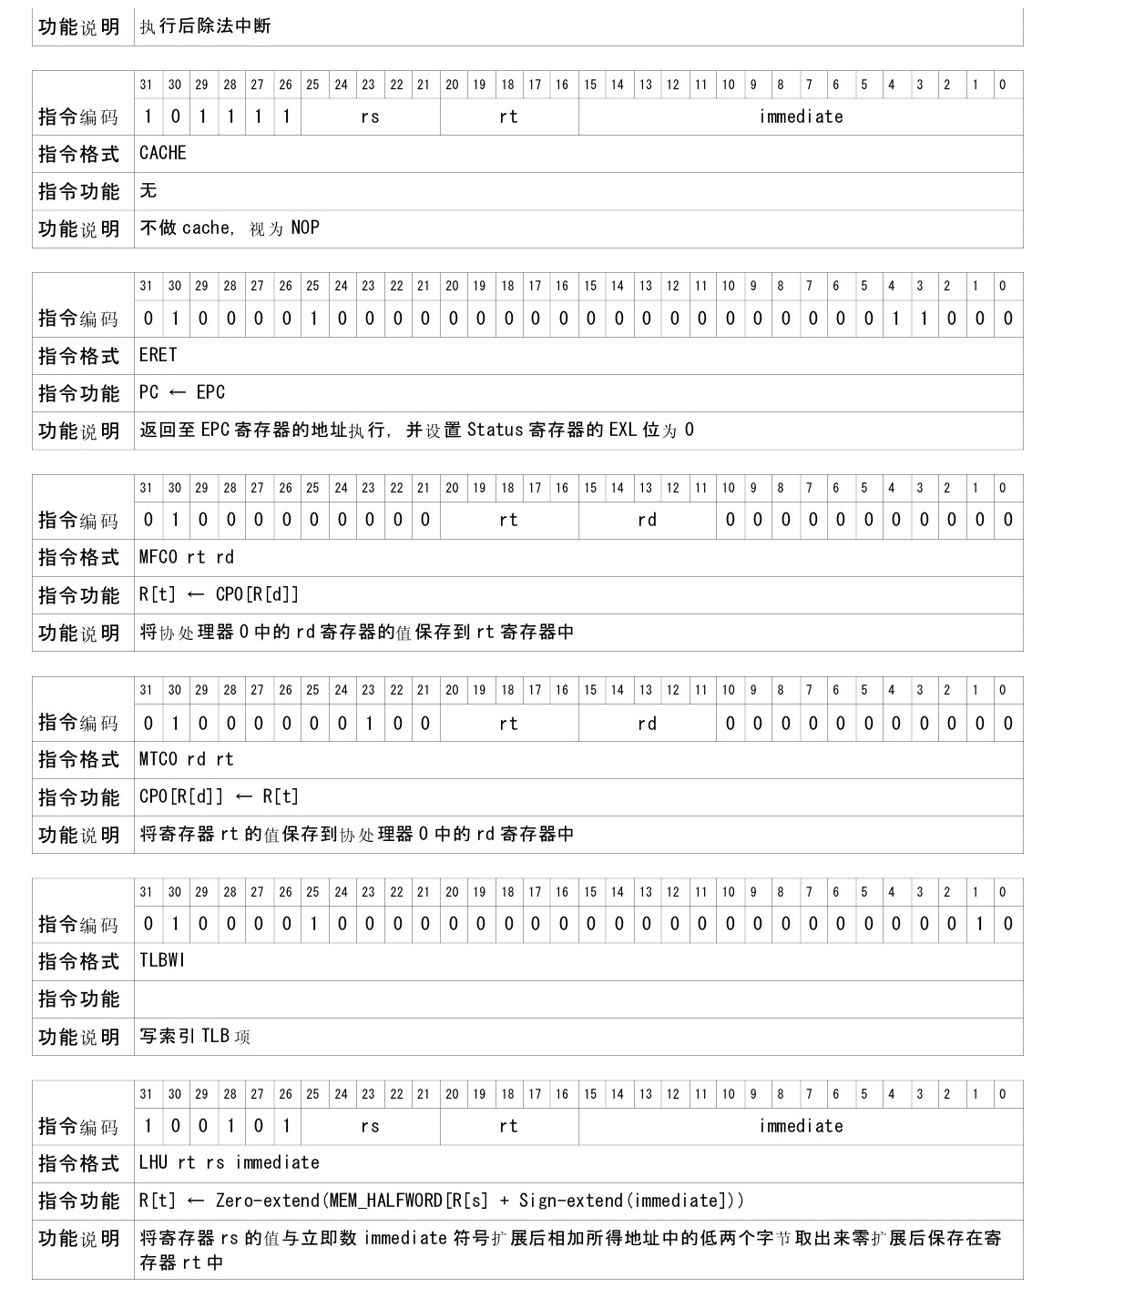
product_requirement_document/chart/insert7.jpg
