JamisHoo/Cache-CPU/documentation/cadb_manual.pdf

# Cache Debugger使用手册

### Cache小组

2015年1月11日

目录

1 引言 | 2
2 概述 | 2
3 硬件部署 | 2
4 软件部署 | 4
5 使用方法 | 4
6 维护 | 5

1

1 引言

### 1.1 编写目的

编写本使用说明的目的是充分叙述本工具所能实现的功能及其运行环境，以 便使用者了解本工具的使用范围和使用方法，并为软件的维护和更新提供必要 的信息。

2 概述

2.1 用途

Cache Debugger是一个基于串口的VHDL通用调试工具。使用本工具可以在 PC端发送指令到硬件系统，具有启动、断点、继续运行、单步调试、查看信号 等多种功能。

### 2.2 系统配置

带有串口的目标设备
支持VHDL语言和该目标设备的集成软件开发环境
Unix或类Unix操作系统，安装有串口设备驱动，支持C++11的编译器

## 3 硬件部署

以一个简单的计时器为例叙述如何将本工具应用于被测试模块。 首先在被测试模块的实体中加入两个输出信号：被查看信号和断点条件。 在结构体的并发处理语句中定义被查看信号和断点条件。被查看信号的定义 可使用工具自动生成，默认8对齐，未使用的用0填充。断点条件未使用的部分 必须用0填充。
在本例中被查看信号共4096位，断点条件64位。被查看的信号microsec-ond类型为std_logic_vector，共10位，用0填充6位以实现8对齐。被查看的信 号millisecond类型为std_logic_vector，共10位，用0填充6位以实现8对齐。断 点条件分别为second、millisecond、microsecond。

entity clock is
Port (clk: in STD_LOGIC;
rst: in STD_LOGIC;
led1: out STD_LOGIC_VECTOR (6 downto 0); led2: out STD_LOGIC_VECTOR (6 downto 0);
+ | out_datas: out STD_LOGIC_VECTOR(4095 downto 0);
+ | monitor: out STD_LOGIC_VECTOR(63 downto 0)
| );
end clock;
| 2

architecture Behavioral of clock is
begin
+ | out_datas(9 downto 0) <= microsecond(9 downto 0);
+ | out_datas(15 downto 10) <= (others => '0');
+ | out_datas(25 downto 16) <= millisecond(9 downto 0);
+ | out_datas(31 downto 26) <= (others => '0');
+ | out_datas(37 downto 32) <= second(5 downto 0);
+ | out_datas(39 downto 38) <= (others => '0');
+ | out_datas(4095 downto 40) <= (others => '0');
+ | monitor <= X"0000" & "000000" & microsecond &
+ | "000000" & millisecond & "0000000000" & second;
end Behavioral;
| 在新的顶层模块中原件例化被调试的模块，并将输出端口对应起来。

entity cadb is
| port(
| clk : in std_logic;
| rst : in std_logic;
+ | led1: out std_logic_vector(6 downto 0);
+ | led2: out std_logic_vector(6 downto 0);
| serialport_txd : out std_logic;
| serialport_rxd : in std_logic
| );
end cadb;
architecture bhv of cadb is +component clock is
+ | port(clk: in std_logic;
+ | rst: in std_logic;
+ | led1: out std_logic_vector(6 downto 0);
+ | led2: out std_logic_vector(6 downto 0);
+ | out_datas: out STD_LOGIC_VECTOR(4095 downto 0);
+ | monitor: out STD_LOGIC_VECTOR(63 downto 0)
+ | );
+end component;
begin
+ | u1: clock port map(clk => bp_clk, rst => rst, led1 => led1, led2 => led2,
+ | out_datas => send_data, monitor => m_monitor
| 3

+ | );
end bhv;
| 将50MHz时钟连接到bp_debug模块的输入时钟，将bp_debug模块的输出
时钟连接到被调试模块的时钟。
为cadb分配串口管脚。

## 4 软件部署

| 首先编写配置文件，配置文件共三列。 第一列是软件端查看变量值时的标签，接受不包含空白字符的字符串。 第二列是VHDL源代码中实际被查看信号名称，接收不包含空白字符的字符

串，在被调试模块中应有同名信号，且该信号不能为输出端口。
| 第三列是被查看信号的范围。对于std_logic_vector应标明范围，对于std_logic
第三列空。
| 配置文件支持#风格的注释。 运行软件端程序cadb gen <目标文件>，信号定义部分VHDL代码将自动生成

并保存在目标文件中。
| 每次更新配置文件后都应该重新生成VHDL代码并将其更新到硬件中。 运行cadb <串口设备路径>，调试工具将启动。

## 5 使用方法

| 软件端程序启动后应该出现如图1所示界面，此时输入命令help可查看帮
助。
所有支持的命令：
1. run: 开始运行。
2. break <value>: 设置断点，支持十六进制（0x）和二进制（0b）。
3. continue: 继续运行。
4. step [n]: 前进n个时钟，n默认为1，支持二进制、八进制、十进制、十六 进制。
5. print[b|x] <label>: 以二进制（0b）或十六进制（0x）打印变量。默认为 十六进制。
6. display[b|x] <label>: 自动打印变量。
7. undisplay <label>: 取消所有该变量的自动打印。
8. help: 显示帮助信息。
9. quit: 退出。

4

输入run相当于被调试模块得到一个reset信号后得到连续的时钟信号，被调 试模块应该在此条件下能正确运行。
输入run、step、continue命令后程序会阻塞，直到到达断点条件，用户才 可继续操作，此时可使用print命令查看信号值。
断点设置有高级用法，参见技术文档。

6 维护

如果在使用中遇到问题请仔细阅读使用手册和技术文档，确保使用方法正 确，满足设计约定。如果问题仍然不能解决，请联系作者，联系方式请咨询本 使用手册提供者。

图 1: 软件端界面

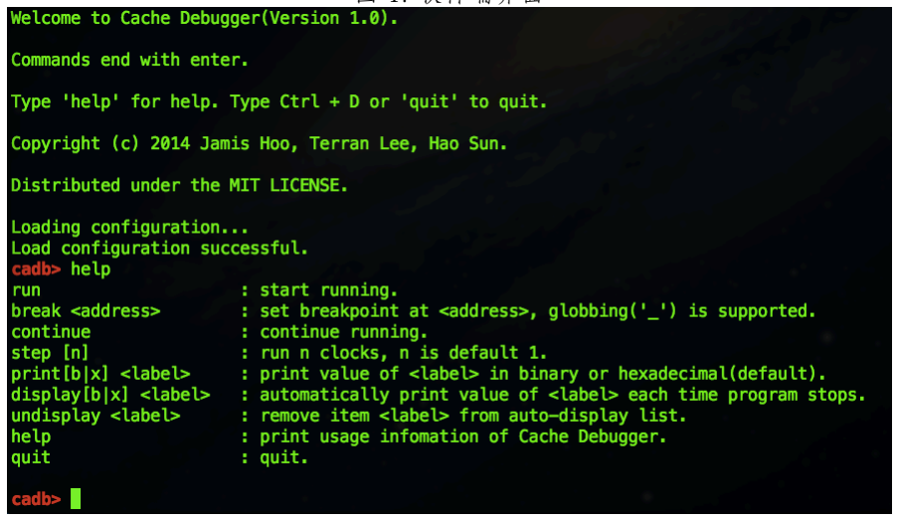
[picture p24: figure]

5
