JamisHoo/Cache-CPU/utils/cadb/manual/sections/section_introduction.tex

\section{引言}
    \subsection{编写目的}
        编写本使用说明的目的是充分叙述本工具所能实现的功能及其运行环境，%
        以便使用者了解本工具的使用范围和使用方法，%
        并为软件的维护和更新提供必要的信息。
