JamisHoo/Cache-CPU/test/fast_clk1/readme.txt

功能：将flash中从零0开始的一些系列数据转存到RAM的0开始的位置。
flash数据格式：每32位为一个数据，第一个数据表示需要转存的数据的数量，之后为需要转存的数据。
注意：	1、烧flash之前记得擦
	2、运行后最右侧应当亮5个灯，如果没亮，请重按复位键。暂不明原因。

后续工作：转存的数据是需要测试的指令，之后将ROM中的程序运行的结果由死循环改为将PC改到RAM的0地址处，开始执行程序。
