JamisHoo/Cache-CPU/test_document/sections/section1_introduction.tex

\section{引言}
    \subsection{编写目的}
        测试是程序开发的一个重要组成部分。%
        需要通过测试证明程序的正确性，%
        并且保证程序能够在各种边界条件、%
        极端情况下都正常工作。%

        测试对于硬件的开发尤为重要，%
        硬件开发中的问题往往比较隐蔽，%
        难以准确定位，调试比较困难。%
        据以往学长参与此实验的经验，%
        在调试方面花费的时间要多于编写程序所花的时间，%
        最终实验成功与否，%
        很大程度上也取决于测试工作进行的是否充分。

        因此，本小组撰写此测试文档，%
        为该实验提出一份完整可行的测试方案，%
        同时也记录我们调试过程中遇到的问题与解决方案，%
        作为之后完成此实验的参考。

    \subsection{测试方案}
        本项目的测试工作从硬件模块的单元测试开始，%
        逐渐将各个模块组合联调，%
        使其最终能够正常运行一个操作系统。%
        总体测试框架如下：
        \begin{enumerate}
        \item
            单元测试
        \item
            单指令测试
        \item
            指令片段测试
        \item
            系统测试
        \end{enumerate}
