JamisHoo/Cache-CPU/product_requirement_document/sections/section3_performance.tex

\section{性能需求}
    实现多周期CPU，性能上可能与流水线存在一定差距，
    尽量通过良好的内部设计弥补，减小各个模块之间的延时。

    主频目标暂定为$6.25MHz$。
