JamisHoo/Cache-CPU/utils/cadb/manual/sections/section_maintenance.tex

\section{维护}
    如果在使用中遇到问题请仔细阅读使用手册和技术文档，%
    确保使用方法正确，满足设计约定。%
    如果问题仍然不能解决，请联系作者，联系方式请咨询本使用手册提供者。
