JamisHoo/Cache-CPU/(commit log)

2014-10-30 use switch case in ram
2014-11-14 control signals updated
    [数据通路3.0.xls]
2014-11-16 add IFetch and IDecode
    [数据通路3.0.xls, 数据通路4.0.xls]
2014-11-17 ifetch tested on board
2014-11-18 rename dirs
    [datapath.xls]
2014-11-19 CP0 and WB
    [.$datapath.xls]
2014-11-20 谁他丫的传上来一堆临时文件和备份文件
    [.$datapath.xls]
2014-11-27 Exception module
    [.$datapath.xls]
2014-11-27 test for deleting temp file
    [.$datapath.xls]
2014-11-30 fix bug on general register
    [IDecode.vhd, general_register.vhd]
2014-11-30 fix warning 9k RAM
    [cacpu.vhd, general_register.vhd, mmu_module.vhd]
2014-11-30 fix bug about general_register
    [general_register.vhd]
2014-12-01 fix bug: enable in mmu_module
    [mmu_module.vhd]
2014-12-03 general register's bug when write back to general registers
    [general_register.vhd]
2014-12-03 a WB's bug which will happen when write back to rd register and rt's address is 0
    [WB.vhd]
2014-12-04 fix bug command JALR
    [IDecode.vhd]
2014-12-04 fix bug IDecode ALUOPs of LUI
    [IDecode.vhd]
2014-12-06 WB bug for J and B instruction
    [WB.vhd]
2014-12-10 bug fix : serial port write enable
    [mmu_module.vhd]
2014-12-11 a WB bug happens when LB
    [WB.vhd]
2014-12-15 fix bug ALU module
    [alu.vhd]
2015-01-03 update cacpu, fix bug: cannot launch when rst
    [IDecode.vhd, WB.vhd, general_register.vhd, mmu_module.vhd]
2015-01-09 add cadb client
    [cadb.cfg]
